atalii/fpga-hdmi/doc/glitching.jpg

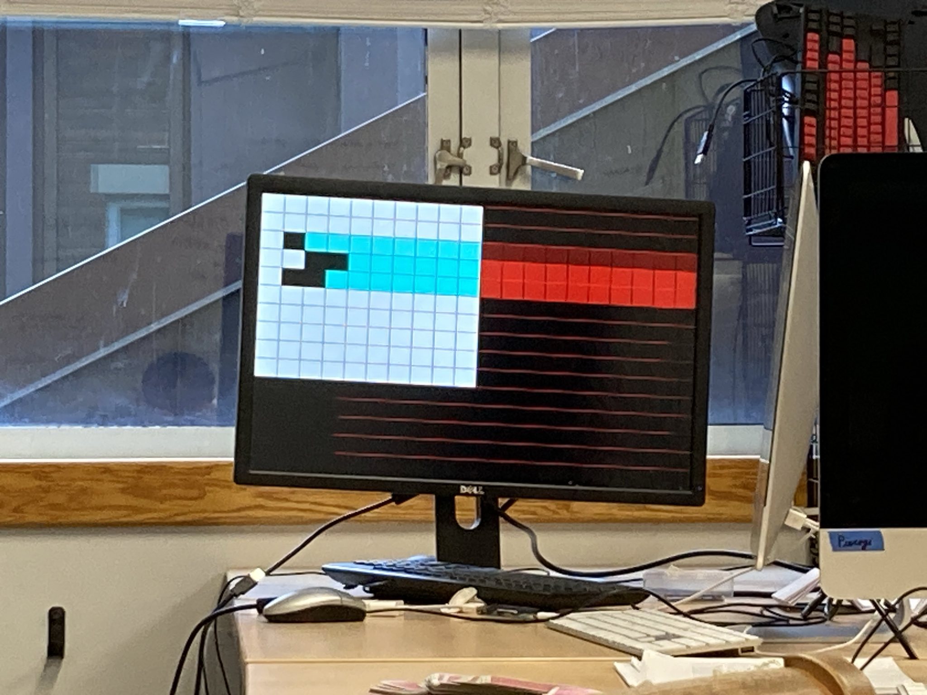
doc/glitching.jpg
