atalii/fpga-hdmi/doc/cover.webp

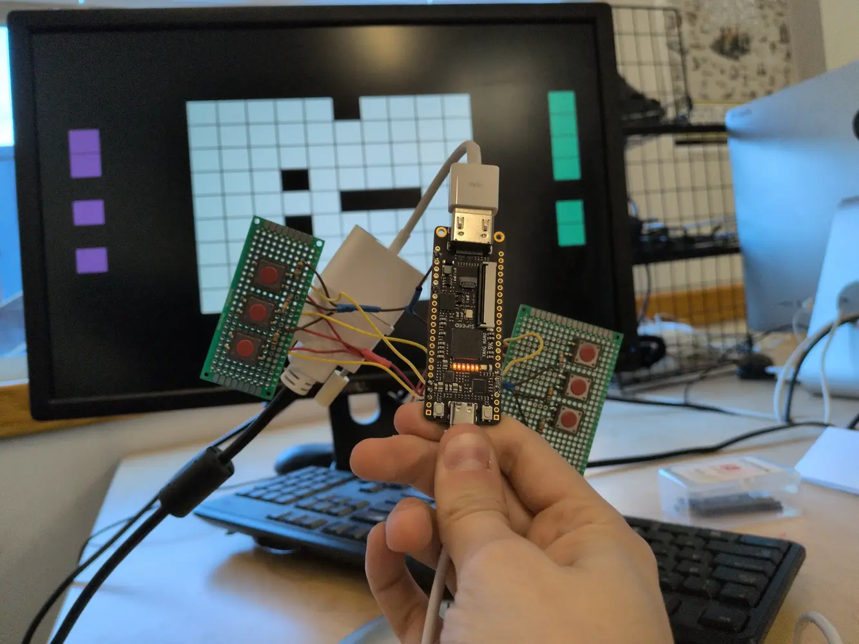
doc/cover.webp
