atalii/fpga-hdmi/README.md

This repository contains the code for what is now my final project in CSCI395
Advanced Computer Architecture.
