atalii/fpga-hdmi/(commit log)

2025-12-04 fix(tmds): use lgoic types; assign bytes in correct order
    [tmds.v]
2025-12-04 fix(tmds): count ones correctly
    bit widths in addition screwed up behavior at least when run compiled by
    verilator. i don't know whether this affected the FPGA.
    [tmds.v]
2025-12-04 fix(tmds): correct branch order
    New code matches spec, lmao.
    [tmds.v]
2025-12-11 fix: set dimensions and center board
    [gol.v, top.v]
2025-12-13 feat: add buttons
    HOLY FUCKING SHIT
2025-12-13 feat: buttons controlling GoL!!!!
    Topology is wrong and debounce logic is missing, but we're so set.
    [gol.v, top.v]
2025-12-14 feat: fix topology
    cylinder, not a torus. this requires modification to how we keep
    score, since it requires special handling in each goal.
    [gol.v]
2025-12-16 doc: show yosys proc'd generated circuit
